CausticLime1/VolleyBot/README.md

CAD Files found here:
https://cad.onshape.com/documents/b71e7f16a9ce3487396680f0/w/fcb58f0d3edd17ba5ccc9372/e/33c9d645b66e250968ced99f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
