CausticLime1/VolleyBot/Electrical/VolleyBot.kicad_pcb

## KiCad design Electrical/VolleyBot.kicad_pcb (2025-12-17)

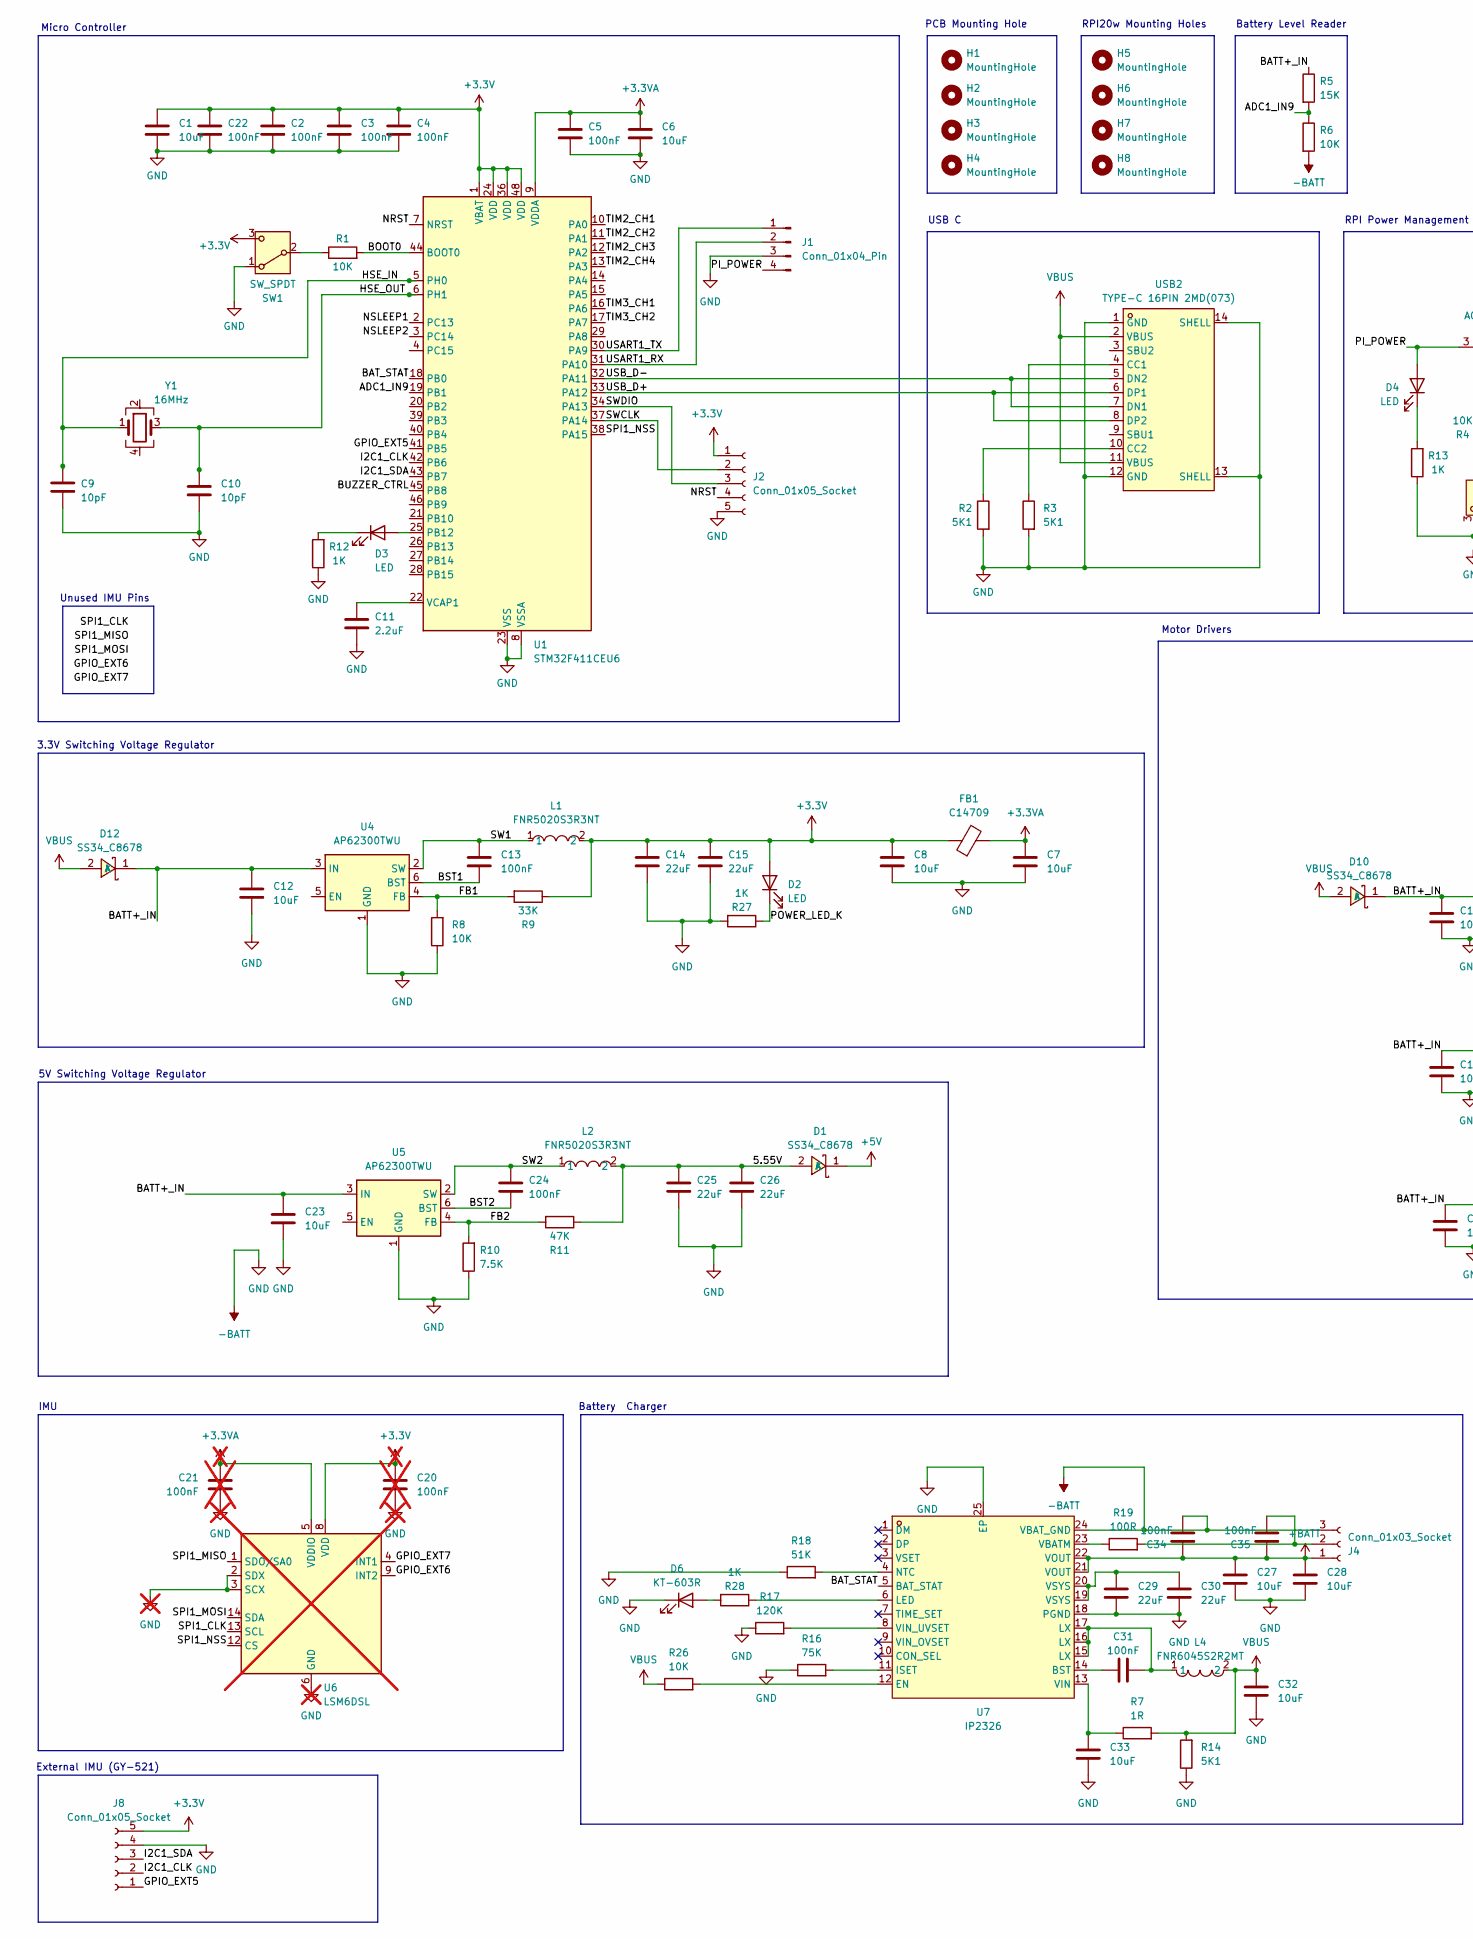
[picture p1: schematic VolleyBot.kicad_sch, part in row 1, column 1]

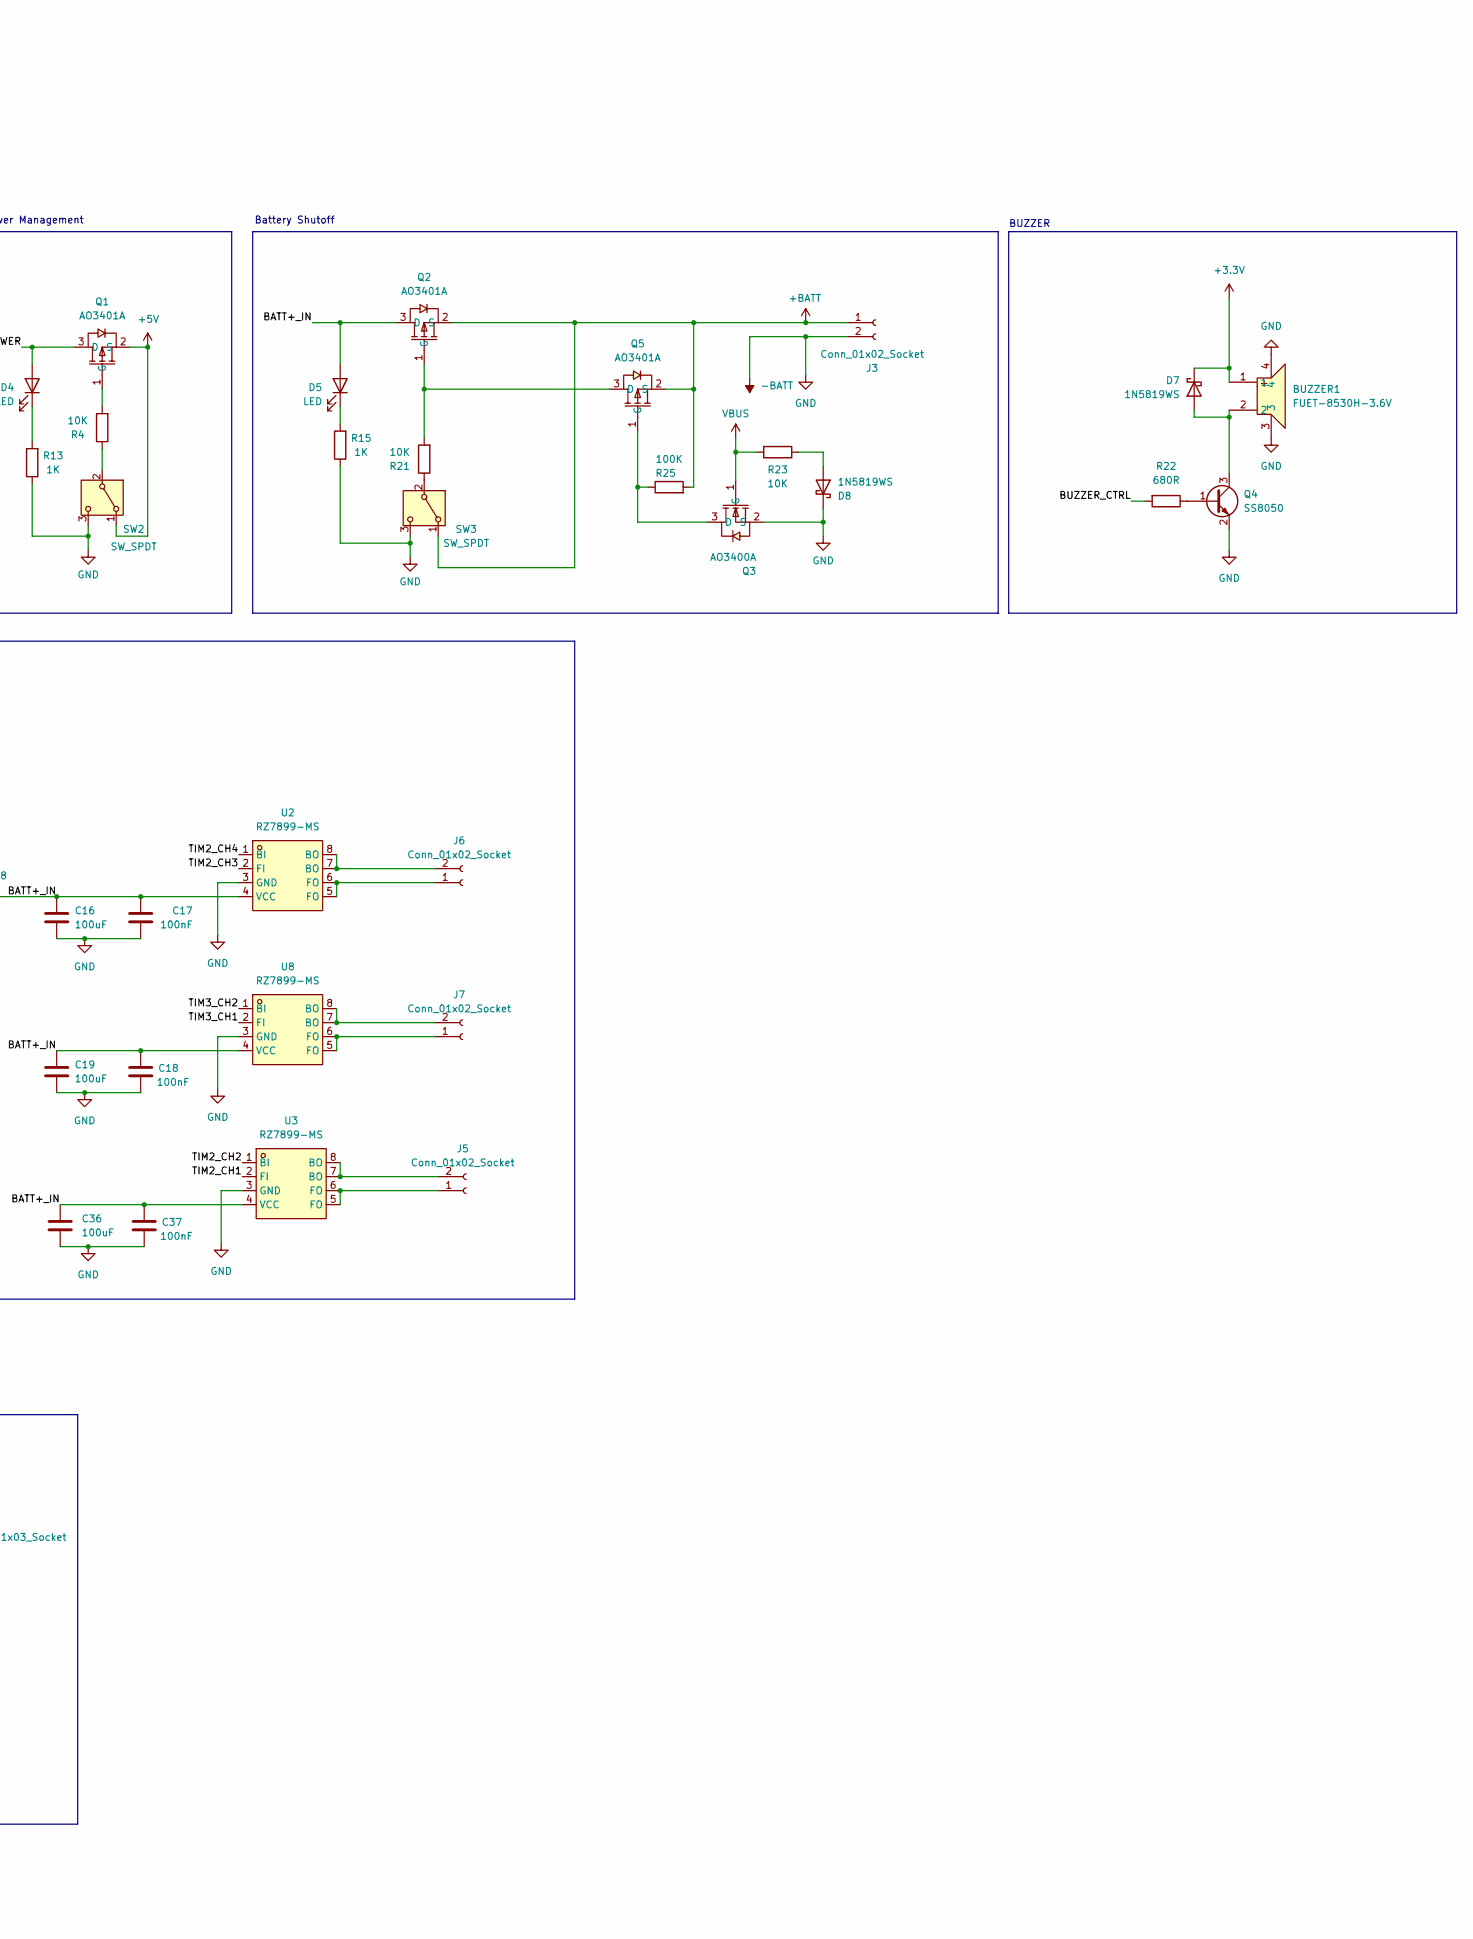
[picture p2: schematic VolleyBot.kicad_sch, part in row 1, column 2]

Parts:
BUZZER1: FUET-8530H-3.6V; BUZ-SMD_4P-L8.5-W8.5_FUET-8530-05; LCSC Part C417429
C1, C6, C12, C23, C27, C28, C32, C33: 10uF; C_0603_1608Metric
C2, C3, C4, C5, C13, C17, C18, C22, C24, C31, C34, C35, C37: 100nF; C_0402_1005Metric
C7, C8: 10uF; C_0805_2012Metric
C9, C10: 10pF; C_0402_1005Metric
C11: 2.2uF; C_0402_1005Metric
C14, C15, C25, C26, C29, C30: 22uF; C_0805_2012Metric
C16, C19, C36: 100uF; C_1206_3216Metric
C20, C21: 100nF; C_0402_1005Metric; not fitted
D1, D10, D12: SS34_C8678; SMA_L4.3-W2.6-LS5.2-RD; LCSC Part C8678
D2, D3, D4, D5: LED; LED_0603_1608Metric
D6: KT-603R; LED_0603_1608Metric
D7, D8: 1N5819WS; D_SOD-323
FB1: C14709; L_0603_1608Metric
H1, H2, H3, H4: MountingHole; MountingHole_2.2mm_M2
H5, H6, H7, H8: MountingHole; MountingHole_2.7mm_M2.5
J1: Conn_01x04_Pin; PinHeader_1x04_P2.54mm_Vertical
J2, J8: Conn_01x05_Socket; JST_XH_S5B-XH-A_1x05_P2.50mm_Horizontal
J3: Conn_01x02_Socket; AMASS_XT60PW-F_1x02_P7.20mm_Horizontal
J4: Conn_01x03_Socket; JST_XH_S3B-XH-A_1x03_P2.50mm_Horizontal
J5, J6, J7: Conn_01x02_Socket; JST_XH_S2B-XH-A_1x02_P2.50mm_Horizontal
L1, L2: FNR5020S3R3NT; IND-SMD_L5.0-W5.0_FNR50XXS; LCSC Part C167926
L4: FNR6045S2R2MT; IND-SMD_L6.0-W6.0_FNR60XXS; LCSC Part C168059
Q1, Q2, Q5: AO3401A; SOT-23_L2.9-W1.3-P1.90-LS2.4-BR; LCSC Part C15127
Q3: AO3400A; SOT-23-3_L2.9-W1.3-P1.90-LS2.4-BR; LCSC Part C20917
Q4: SS8050; SOT-23
R1, R4, R6, R8, R21, R23, R26: 10K; R_0402_1005Metric
R2, R3, R14: 5K1; R_0402_1005Metric
R5: 15K; R_0402_1005Metric
R7: 1R; R_0603_1608Metric
R9: 33K; R_0402_1005Metric
R10: 7.5K; R_0603_1608Metric
R11: 47K; R_0603_1608Metric
R12, R13, R15, R27, R28: 1K; R_0402_1005Metric
R16: 75K; R_0603_1608Metric
R17: 120K; R_0603_1608Metric
R18: 51K; R_0603_1608Metric
R19: 100R; R_1206_3216Metric
R22: 680R; R_0603_1608Metric
R25: 100K; R_0603_1608Metric
SW1, SW2, SW3: SW_SPDT; SW_SPDT_PCM12
U1: STM32F411CEU6; QFN-48-1EP_7x7mm_P0.5mm_EP5.6x5.6mm
U2, U3, U8: RZ7899-MS; SOIC-8_L4.9-W3.9-P1.27-LS6.0-BL; LCSC Part C22462553
U4, U5: AP62300TWU; TSOT-23-6
U6: LSM6DSL; LGA-14_3x2.5mm_P0.5mm_LayoutBorder3x4y; not fitted
U7: IP2326; VQFN-24_L4.0-W4.0-P0.50-BL-EP2.5; LCSC Part C2832094
USB2: TYPE-C 16PIN 2MD(073); USB-C-SMD_TYPE-C-6PIN-2MD-073; LCSC Part C2765186
Y1: 16MHz; Crystal_SMD_3225-4Pin_3.2x2.5mm

Connections:
+3.3V: BUZZER1.1, C1.1, C2.1, C3.1, C4.1, C8.1, C14.1, C15.1, C20.1, C22.1, D2.2 (A), D7.1 (K), FB1.1, J2.1, J8.5, L1.2, R9.1, SW1.3 (C), U1.1 (VBAT), U1.24 (VDD), U1.36 (VDD), U1.48 (VDD), U6.8 (VDD)
+3.3VA: C5.1, C6.1, C7.1, C21.1, FB1.2, U1.9 (VDDA), U6.5 (VDDIO)
+5V: D1.1 (K), Q1.2 (S), SW2.1 (A)
+BATT: C27.1, C28.1, C34.1, C35.1, J3.1, J4.1, Q2.2 (S), Q5.2 (S), R25.2, SW3.1 (A), U7.21 (VOUT), U7.22 (VOUT)
-BATT: BUZZER1.3, BUZZER1.4, C1.2, C2.2, C3.2, C4.2, C5.2, C6.2, C7.2, C8.2, C9.2, C10.2, C11.2, C12.2, C14.2, C15.2, C16.2, C17.2, C18.2, C19.2, C20.2, C21.2, C22.2, C23.2, C25.2, C26.2, C27.2, C28.2, C29.2, C30.2, C32.2, C33.2, C34.2, C36.2, C37.2, D6.1 (K), D8.1 (K), J1.3, J2.5, J3.2, J4.3, J8.4, Q3.2 (S), Q4.2 (E), R2.2, R3.2, R6.2, R8.1, R10.1, R12.1, R13.1, R14.1, R15.1, R16.1, R17.1, R18.1, R27.2, SW1.1 (A), SW2.3 (C), SW3.3 (C), U1.8 (VSSA), U1.23 (VSS), U1.35 (VSS), U1.47 (VSS), U1.49 (VSS), U2.3 (GND), U3.3 (GND), U4.1 (GND), U5.1 (GND), U6.2 (SDX), U6.3 (SCX), U6.6 (GND), U6.7 (GND), U7.18 (PGND), U7.24 (VBAT_GND), U7.25 (EP), U8.3 (GND), USB2.1 (GND), USB2.12 (GND), USB2.13 (SHELL), USB2.14 (SHELL)
/5.55V: C25.1, C26.1, D1.2 (A), L2.2, R11.1
/ADC1_IN9: R5.2, R6.1, U1.19 (PB1)
/BATT+_IN: C12.1, C16.1, C17.1, C18.1, C19.1, C23.1, C36.1, C37.1, D5.2 (A), D10.1 (K), D12.1 (K), Q2.3 (D), R5.1, U2.4 (VCC), U3.4 (VCC), U4.3 (IN), U5.3 (IN), U8.4 (VCC)
/BAT_STAT: U1.18 (PB0), U7.5 (BAT_STAT)
/BOOT0: R1.2, U1.44 (BOOT0)
/BST1: C13.1, U4.6 (BST)
/BST2: C24.1, U5.6 (BST)
/BUZZER_CTRL: R22.2, U1.45 (PB8)
/FB1: R8.2, R9.2, U4.4 (FB)
/FB2: R10.2, R11.2, U5.4 (FB)
/GPIO_EXT5: J8.1, U1.41 (PB5)
/HSE_IN: C9.1, U1.5 (PH0), Y1.1
/HSE_OUT: C10.1, U1.6 (PH1), Y1.3
/I2C1_CLK: J8.2, U1.42 (PB6)
/I2C1_SDA: J8.3, U1.43 (PB7)
/NRST: J2.4, U1.7 (NRST)
/NSLEEP1: U1.2 (PC13)
/NSLEEP2: U1.3 (PC14)
/PI_POWER: D4.2 (A), J1.4, Q1.3 (D)
/POWER_LED_K: D2.1 (K), R27.1
/SPI1_NSS: U1.38 (PA15), U6.12 (CS)
/SW1: C13.2, L1.1, U4.2 (SW)
/SW2: C24.2, L2.1, U5.2 (SW)
/SWCLK: J2.2, U1.37 (PA14)
/SWDIO: J2.3, U1.34 (PA13)
/TIM2_CH1: U1.10 (PA0), U3.2 (FI)
/TIM2_CH2: U1.11 (PA1), U3.1 (BI)
/TIM2_CH3: U1.12 (PA2), U2.2 (FI)
/TIM2_CH4: U1.13 (PA3), U2.1 (BI)
/TIM3_CH1: U1.16 (PA6), U8.2 (FI)
/TIM3_CH2: U1.17 (PA7), U8.1 (BI)
/USART1_RX: J1.2, U1.31 (PA10)
/USART1_TX: J1.1, U1.30 (PA9)
/USB_D+: U1.33 (PA12), USB2.6 (DP1), USB2.8 (DP2)
/USB_D-: U1.32 (PA11), USB2.5 (DN2), USB2.7 (DN1)
unnamed: C29.1, C30.1, U7.19 (VSYS), U7.20 (VSYS)
unnamed: C31.2, L4.1, U7.15 (LX), U7.16 (LX), U7.17 (LX)
unnamed: D3.2 (A), U1.25 (PB12)
unnamed: D3.1 (K), R12.2
unnamed: D4.1 (K), R13.2
unnamed: D5.1 (K), R15.2
unnamed: D6.2 (A), R28.2
unnamed: BUZZER1.2, D7.2 (A), Q4.3 (C)
unnamed: D8.2 (A), R23.1
unnamed: C35.2, J4.2, R19.2
unnamed: J5.1, U3.5 (FO), U3.6 (FO)
unnamed: J5.2, U3.7 (BO), U3.8 (BO)
unnamed: J6.1, U2.5 (FO), U2.6 (FO)
unnamed: J6.2, U2.7 (BO), U2.8 (BO)
unnamed: J7.1, U8.5 (FO), U8.6 (FO)
unnamed: J7.2, U8.7 (BO), U8.8 (BO)
unnamed: Q1.1 (G), R4.2
unnamed: Q2.1 (G), Q5.3 (D), R21.2
unnamed: Q3.3 (D), Q5.1 (G), R25.1
unnamed: Q4.1 (B), R22.1
unnamed: R1.1, SW1.2 (B)
unnamed: R4.1, SW2.2 (B)
unnamed: R21.1, SW3.2 (B)
unnamed: C11.1, U1.22 (VCAP1)
unnamed: C31.1, U7.14 (BST)
unnamed: R26.2, U7.12 (EN)
unnamed: R16.2, U7.11 (ISET)
unnamed: R28.1, U7.6 (LED)
unnamed: R18.2, U7.4 (NTC)
unnamed: R19.1, U7.23 (VBATM)
unnamed: C33.1, R7.1, U7.13 (VIN)
unnamed: R17.2, U7.8 (VIN_UVSET)
unnamed: R3.1, USB2.4 (CC1)
unnamed: R2.1, USB2.10 (CC2)
VBUS: C32.1, D10.2 (A), D12.2 (A), L4.2, Q3.1 (G), R7.2, R14.2, R23.2, R26.1, USB2.2 (VBUS), USB2.11 (VBUS)

Notes on the sheet:
External IMU (GY-521)
IMU
Unused IMU Pins
BUZZER
5V Switching Voltage Regulator
Battery Shutoff
Battery Level Reader
RPI Power Management
3.3V Switching Voltage Regulator
Micro Controller
RPI20w Mounting Holes
PCB Mounting Hole
Battery Charger
Motor Drivers
USB C

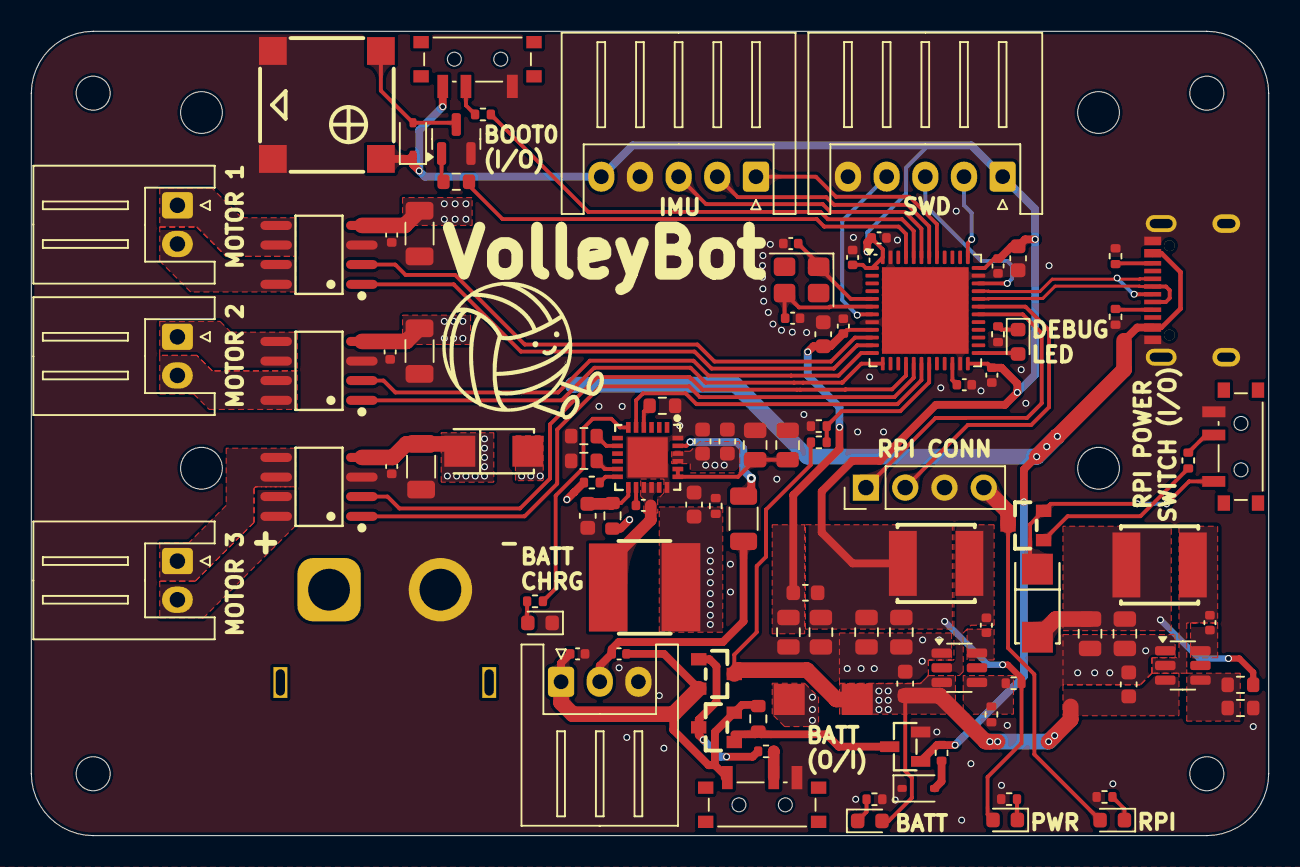
[picture p3: board VolleyBot.kicad_pcb from above]

Board: 2 copper layers, 80.0 x 52.0 mm, 109 parts (0 on the bottom side), 72 nets.
