CausticLime1/VolleyBot/cubemx/Volleybot.ioc

Mcu.UserName=STM32F411CEUx
PA0-WKUP.Signal=S_TIM2_CH1_ETR
PA1.Signal=S_TIM2_CH2
PA10.Signal=USART1_RX
PA11.Signal=USB_OTG_FS_DM
PA12.Signal=USB_OTG_FS_DP
PA13.Signal=SYS_JTMS-SWDIO
PA14.Signal=SYS_JTCK-SWCLK
PA2.Signal=S_TIM2_CH3
PA3.Signal=S_TIM2_CH4
PA6.Signal=S_TIM3_CH1
PA7.Signal=S_TIM3_CH2
PA9.Signal=USART1_TX
PB0.Signal=GPIO_Input
PB1.Signal=ADCx_IN9
PB10.Signal=GPIO_Input
PB12.Signal=GPIO_Output
PB5.Signal=GPXTI5
PB6.Signal=I2C1_SCL
PB7.Signal=I2C1_SDA
PB9.Signal=S_TIM4_CH4
PC13-ANTI_TAMP.Signal=GPIO_Output
PC14-OSC32_IN.Signal=GPIO_Output
