CausticLime1/VolleyBot/(commit log)

2025-06-01 routed pcb
    [VolleyBot.kicad_pcb, VolleyBot.kicad_sch]
2025-06-02 pcb made
    [VolleyBot-B_Cu.gbr, VolleyBot-B_Mask.gbr, VolleyBot-B_Paste.gbr, VolleyBot-B_Silkscreen.gbr, VolleyBot-Edge_Cuts.gbr, VolleyBot-F_Cu.gbr, VolleyBot-F_Mask.gbr, VolleyBot-F_Paste.gbr]
2025-06-03 correction of manufacturing files
    [VolleyBot-B_Cu.gbr, VolleyBot-B_Mask.gbr, VolleyBot-B_Paste.gbr, VolleyBot-B_Silkscreen.gbr, VolleyBot-Edge_Cuts.gbr, VolleyBot-F_Cu.gbr, VolleyBot-F_Mask.gbr, VolleyBot-F_Paste.gbr]
2025-11-30 bat charge
    [VolleyBot.kicad_sch]
2025-11-30 schem done
    [VolleyBot.kicad_pcb, VolleyBot.kicad_sch, Volleybot.cfg]
2025-12-02 final V2
    [VolleyBot-B_Cu.gbr, VolleyBot-B_Mask.gbr, VolleyBot-B_Paste.gbr, VolleyBot-B_Silkscreen.gbr, VolleyBot-Edge_Cuts.gbr, VolleyBot-F_Cu.gbr, VolleyBot-F_Mask.gbr, VolleyBot-F_Paste.gbr]
2025-12-18 updated RTOS
    [VolleyBot.kicad_sch]
2025-12-20 winter break push
    [VolleyBot.kicad_sch]
